cnlohr/x32-ws2812-usbhs-breakout/README.md

# 32x parallel WS 2812 Driver with High-Speed USB

This project leverages the CH32V305's USB High Speed USB interface as well as its timer-driven DMA to enable outputting to thousands of LEDs at >144 Hz!

(More documentation coming soon)
