cnlohr/x32-ws2812-usbhs-breakout/hardware-atx-psu-12v-led/mainboard.kicad_pcb

## KiCad design hardware-atx-psu-12v-led/mainboard.kicad_pcb (2025-12-19)

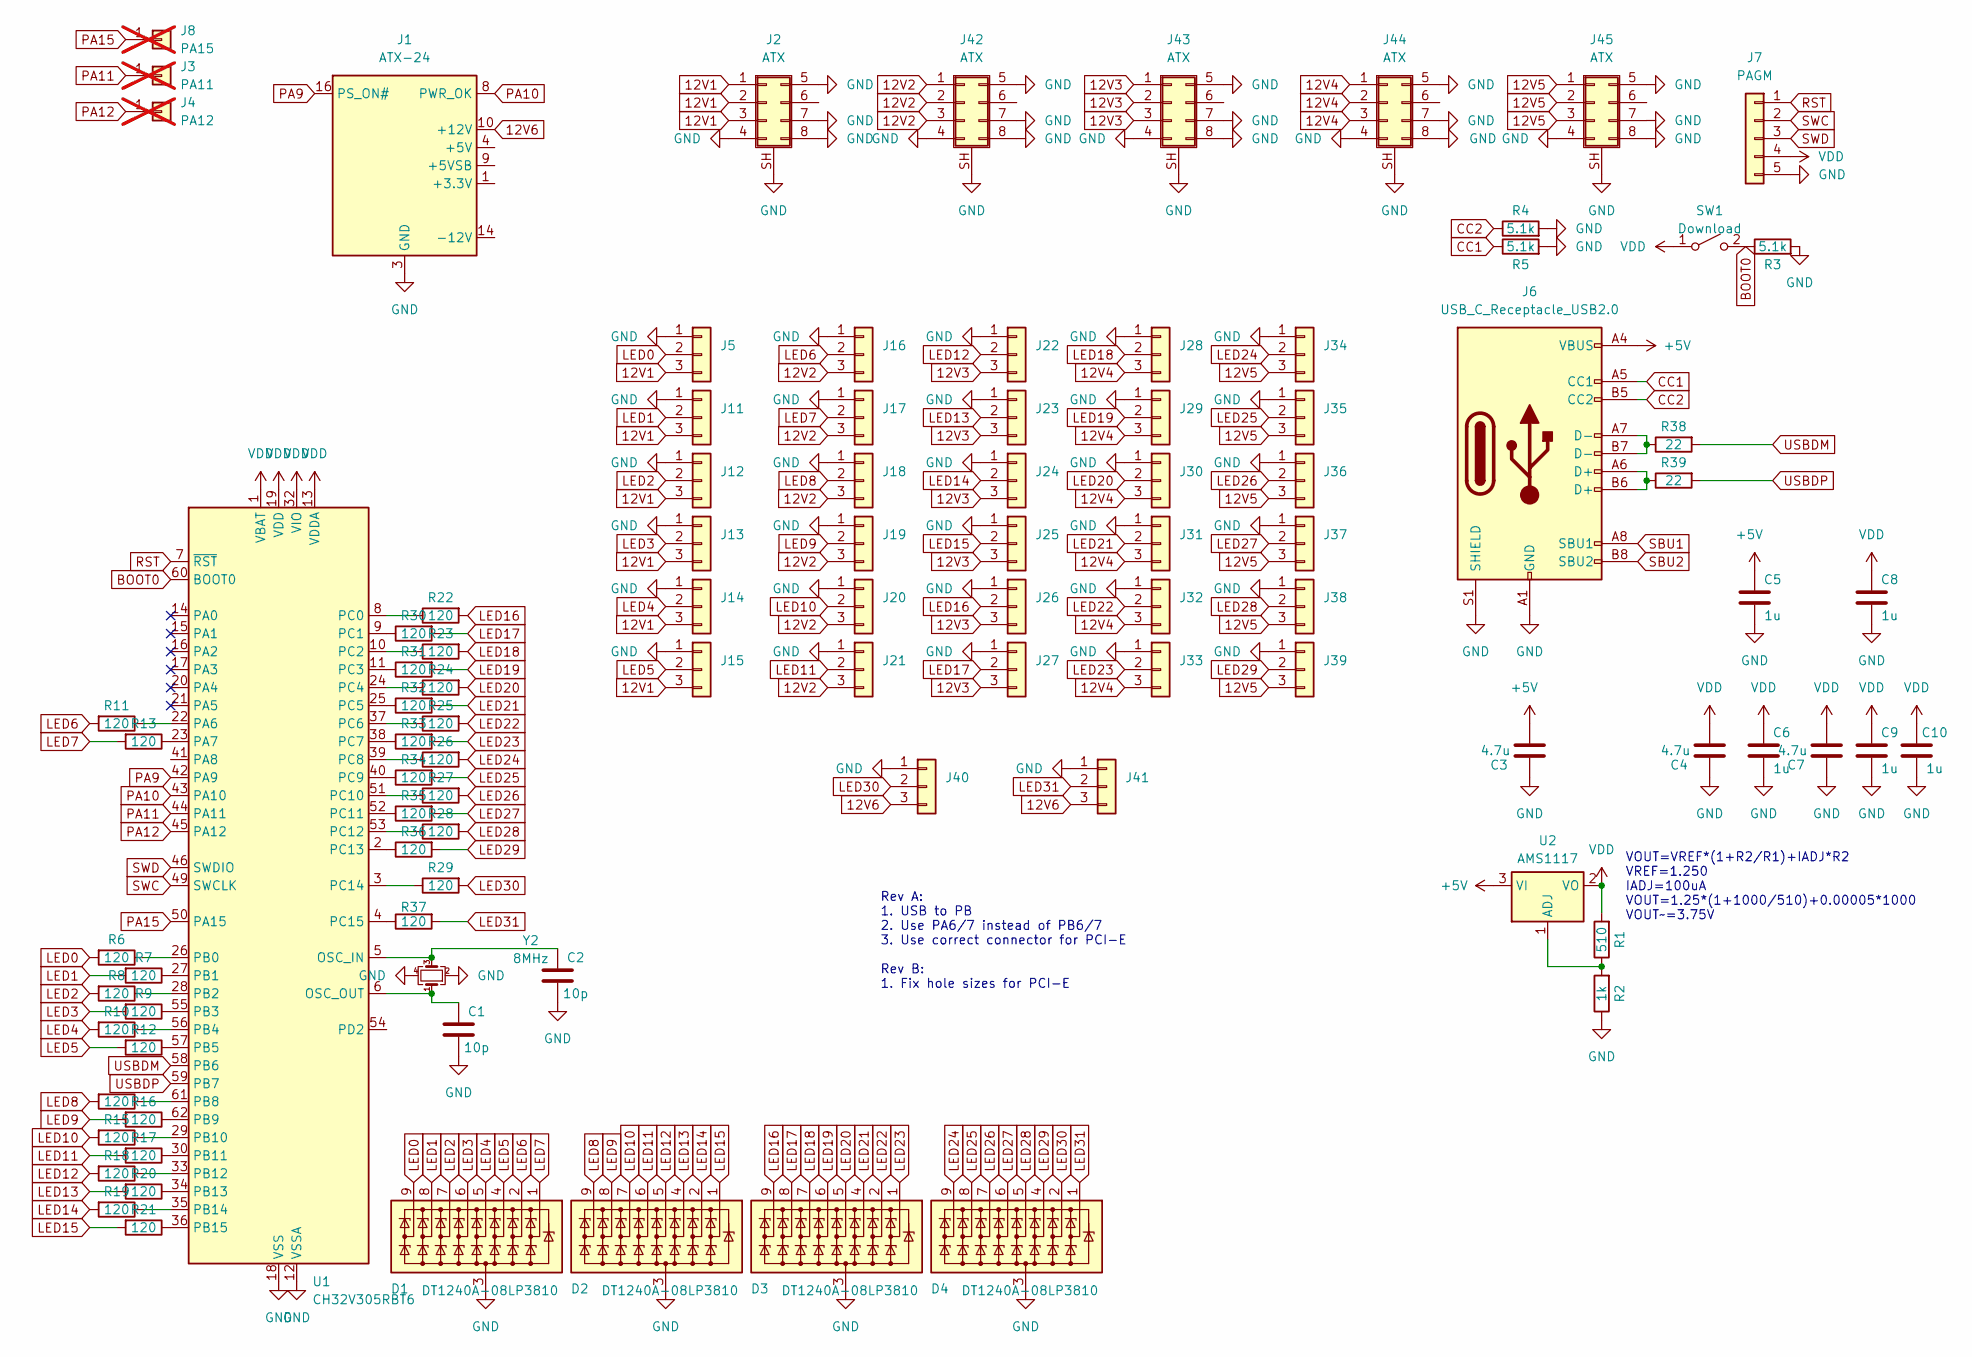
[picture p1: schematic mainboard.kicad_sch]

Parts:
C1, C2: 10p; R_0402_1005Metric; LCSC C32949
C3, C4, C7: 4.7u; C_0805_2012Metric; LCSC C1779
C5, C6, C8, C9, C10: 1u; R_0402_1005Metric; LCSC C52923
D1, D2, D3, D4: DT1240A-08LP3810; UDFN-9_1.0x3.8mm_P0.5mm; LCSC C526598
J1: ATX-24; Molex_Mini-Fit_Jr_5566-24A2_2x12_P4.20mm_Vertical; LCSC C114125
J2, J42, J43, J44, J45: ATX; Molex_Mini-Fit_-PCI_EXPRESS-_2x04_P4.20mm_Vertical; LCSC C2886679
J3: PA11; TestPoint_Pad_D1.0mm; not fitted
J4: PA12; TestPoint_Pad_D1.0mm; not fitted
J5, J11, J12, J13, J14, J15, J16, J17, J18, J19, J20, J21, J22, J23, J24, J25, J26, J27, J28, J29, J30, J31, J32, J33, J34, J35, J36, J37, J38, J39, J40, J41: LED; TerminalBlock_TE_282834-3_1x03_P2.54mm_Horizontal; LCSC C234181
J6: USB_C_Receptacle_USB2.0; USB_C_Receptacle_HRO_TYPE-C-31-M-12; LCSC C2765186
J7: PAGM; PinHeader_1x05_P2.54mm_Vertical; LCSC C32713271
J8: PA15; TestPoint_Pad_D1.0mm; not fitted
R1: 510; R_0402_1005Metric; LCSC C25123
R2: 1k; R_0402_1005Metric; LCSC C11702
R3, R4, R5: 5.1k; R_0402_1005Metric; LCSC C25905
R6, R7, R8, R9, R10, R11, R12, R13, R14, R15, R16, R17, R18, R19, R20, R21, R22, R23, R24, R25, R26, R27, R28, R29, R30, R31, R32, R33, R34, R35, R36, R37: 120; R_0402_1005Metric; LCSC C25079
R38, R39: 22; R_0402_1005Metric; LCSC C25092
SW1: Download; SW_SPST_TL3342; LCSC C318884
U1: CH32V305RBT6; LQFP-64_10x10mm_P0.5mm; LCSC C5187529
U2: AMS1117; SOT-223-3_TabPin2; LCSC C110475
Y2: 8MHz; Crystal_SMD_3225-4Pin_3.2x2.5mm_HandSoldering; LCSC C367183

Connections:
12V1: J2.1, J2.2, J2.3, J5.3, J11.3, J12.3, J13.3, J14.3, J15.3
12V2: J16.3, J17.3, J18.3, J19.3, J20.3, J21.3, J42.1, J42.2, J42.3
12V3: J22.3, J23.3, J24.3, J25.3, J26.3, J27.3, J43.1, J43.2, J43.3
12V4: J28.3, J29.3, J30.3, J31.3, J32.3, J33.3, J44.1, J44.2, J44.3
12V5: J34.3, J35.3, J36.3, J37.3, J38.3, J39.3, J45.1, J45.2, J45.3
12V6: J1.10 (+12V), J1.11 (+12V), J40.3, J41.3
+5V: C3.2, C5.2, J6.A4 (VBUS), J6.A9 (VBUS), J6.B4 (VBUS), J6.B9 (VBUS), U2.3 (VI)
BOOT0: R3.1, SW1.2 (B), U1.60 (BOOT0)
CC1: J6.A5 (CC1), R5.1
CC2: J6.B5 (CC2), R4.1
GND: C1.1, C2.1, C3.1, C4.1, C5.1, C6.1, C7.1, C8.1, C9.1, C10.1, D1.3 (A), D2.3 (A), D3.3 (A), D4.3 (A), J1.3 (GND), J1.5 (GND), J1.7 (GND), J1.15 (GND), J1.17 (GND), J1.18 (GND), J1.19 (GND), J1.24 (GND), J2.4, J2.5, J2.7, J2.8, J2.SH (Shield), J5.1, J6.A1 (GND), J6.A12 (GND), J6.B1 (GND), J6.B12 (GND), J6.S1 (SHIELD), J7.5, J11.1, J12.1, J13.1, J14.1, J15.1, J16.1, J17.1, J18.1, J19.1, J20.1, J21.1, J22.1, J23.1, J24.1, J25.1, J26.1, J27.1, J28.1, J29.1, J30.1, J31.1, J32.1, J33.1, J34.1, J35.1, J36.1, J37.1, J38.1, J39.1, J40.1, J41.1, J42.4, J42.5, J42.7, J42.8, J42.SH (Shield), J43.4, J43.5, J43.7, J43.8, J43.SH (Shield), J44.4, J44.5, J44.7, J44.8, J44.SH (Shield), J45.4, J45.5, J45.8, J45.SH (Shield), R2.1, R3.2, R4.2, R5.2, U1.12 (VSSA), U1.18 (VSS), U1.31 (VSS), U1.47 (VSS), U1.63 (VSS), Y2.2, Y2.4
LED0: D1.9 (K8), J5.2, R6.2
LED1: D1.8 (K7), J11.2, R7.2
LED2: D1.7 (K6), J12.2, R8.2
LED3: D1.6 (K5), J13.2, R9.2
LED4: D1.5 (K4), J14.2, R10.2
LED5: D1.4 (K3), J15.2, R12.2
LED6: D1.2 (K2), J16.2, R11.2
LED7: D1.1 (K1), J17.2, R13.2
LED8: D2.9 (K8), J18.2, R14.2
LED9: D2.8 (K7), J19.2, R16.2
LED10: D2.7 (K6), J20.2, R15.2
LED11: D2.6 (K5), J21.2, R17.2
LED12: D2.5 (K4), J22.2, R18.2
LED13: D2.4 (K3), J23.2, R20.2
LED14: D2.2 (K2), J24.2, R19.2
LED15: D2.1 (K1), J25.2, R21.2
LED16: D3.9 (K8), J26.2, R22.2
LED17: D3.8 (K7), J27.2, R30.2
LED18: D3.7 (K6), J28.2, R23.2
LED19: D3.6 (K5), J29.2, R31.2
LED20: D3.5 (K4), J30.2, R24.2
LED21: D3.4 (K3), J31.2, R32.2
LED22: D3.2 (K2), J32.2, R25.2
LED23: D3.1 (K1), J33.2, R33.2
LED24: D4.9 (K8), J34.2, R26.2
LED25: D4.8 (K7), J35.2, R34.2
LED26: D4.7 (K6), J36.2, R27.2
LED27: D4.6 (K5), J37.2, R35.2
LED28: D4.5 (K4), J38.2, R28.2
LED29: D4.4 (K3), J39.2, R36.2
LED30: D4.2 (K2), J40.2, R29.2
LED31: D4.1 (K1), J41.2, R37.2
unnamed: J1.1 (+3.3V), J1.2 (+3.3V), J1.12 (+3.3V), J1.13 (+3.3V)
unnamed: J1.4 (+5V), J1.6 (+5V), J1.21 (+5V), J1.22 (+5V), J1.23 (+5V)
unnamed: J6.A6 (D+), J6.B6 (D+), R39.1
unnamed: J6.A7 (D-), J6.B7 (D-), R38.1
unnamed: C2.2, U1.5 (OSC_IN), Y2.3
unnamed: C1.2, U1.6 (OSC_OUT), Y2.1
unnamed: R11.1, U1.22 (PA6)
unnamed: R13.1, U1.23 (PA7)
unnamed: R6.1, U1.26 (PB0)
unnamed: R7.1, U1.27 (PB1)
unnamed: R8.1, U1.28 (PB2)
unnamed: R9.1, U1.55 (PB3)
unnamed: R10.1, U1.56 (PB4)
unnamed: R12.1, U1.57 (PB5)
unnamed: R14.1, U1.61 (PB8)
unnamed: R16.1, U1.62 (PB9)
unnamed: R15.1, U1.29 (PB10)
unnamed: R17.1, U1.30 (PB11)
unnamed: R18.1, U1.33 (PB12)
unnamed: R20.1, U1.34 (PB13)
unnamed: R19.1, U1.35 (PB14)
unnamed: R21.1, U1.36 (PB15)
unnamed: R22.1, U1.8 (PC0)
unnamed: R30.1, U1.9 (PC1)
unnamed: R23.1, U1.10 (PC2)
unnamed: R31.1, U1.11 (PC3)
unnamed: R24.1, U1.24 (PC4)
unnamed: R32.1, U1.25 (PC5)
unnamed: R25.1, U1.37 (PC6)
unnamed: R33.1, U1.38 (PC7)
unnamed: R26.1, U1.39 (PC8)
unnamed: R34.1, U1.40 (PC9)
unnamed: R27.1, U1.51 (PC10)
unnamed: R35.1, U1.52 (PC11)
unnamed: R28.1, U1.53 (PC12)
unnamed: R36.1, U1.2 (PC13)
unnamed: R29.1, U1.3 (PC14)
unnamed: R37.1, U1.4 (PC15)
unnamed: R1.1, R2.2, U2.1 (ADJ)
PA9: J1.16 (PS_ON#), U1.42 (PA9)
PA10: J1.8 (PWR_OK), U1.43 (PA10)
PA11: J3.1, U1.44 (PA11)
PA12: J4.1, U1.45 (PA12)
PA15: J8.1, U1.50 (PA15)
RST: J7.1, U1.7 (~RST)
SBU1: J6.A8 (SBU1)
SBU2: J6.B8 (SBU2)
SWC: J7.2, U1.49 (SWCLK)
SWD: J7.3, U1.46 (SWDIO)
USBDM: R38.2, U1.58 (PB6)
USBDP: R39.2, U1.59 (PB7)
VDD: C4.2, C6.2, C7.2, C8.2, C9.2, C10.2, J7.4, R1.2, SW1.1 (A), U1.1 (VBAT), U1.13 (VDDA), U1.19 (VDD), U1.32 (VIO), U1.48 (VDD), U1.64 (VIO), U2.2 (VO)

Notes on the sheet:
Rev A: 1. USB to PB 2. Use PA6/7 instead of PB6/7 3. Use correct connector for PCI-E Rev B: 1. Fix hole sizes for PCI-E
VOUT=VREF*(1+R2/R1)+IADJ*R2 VREF=1.250 IADJ=100uA VOUT=1.25*(1+1000/510)+0.00005*1000 VOUT~=3.75V

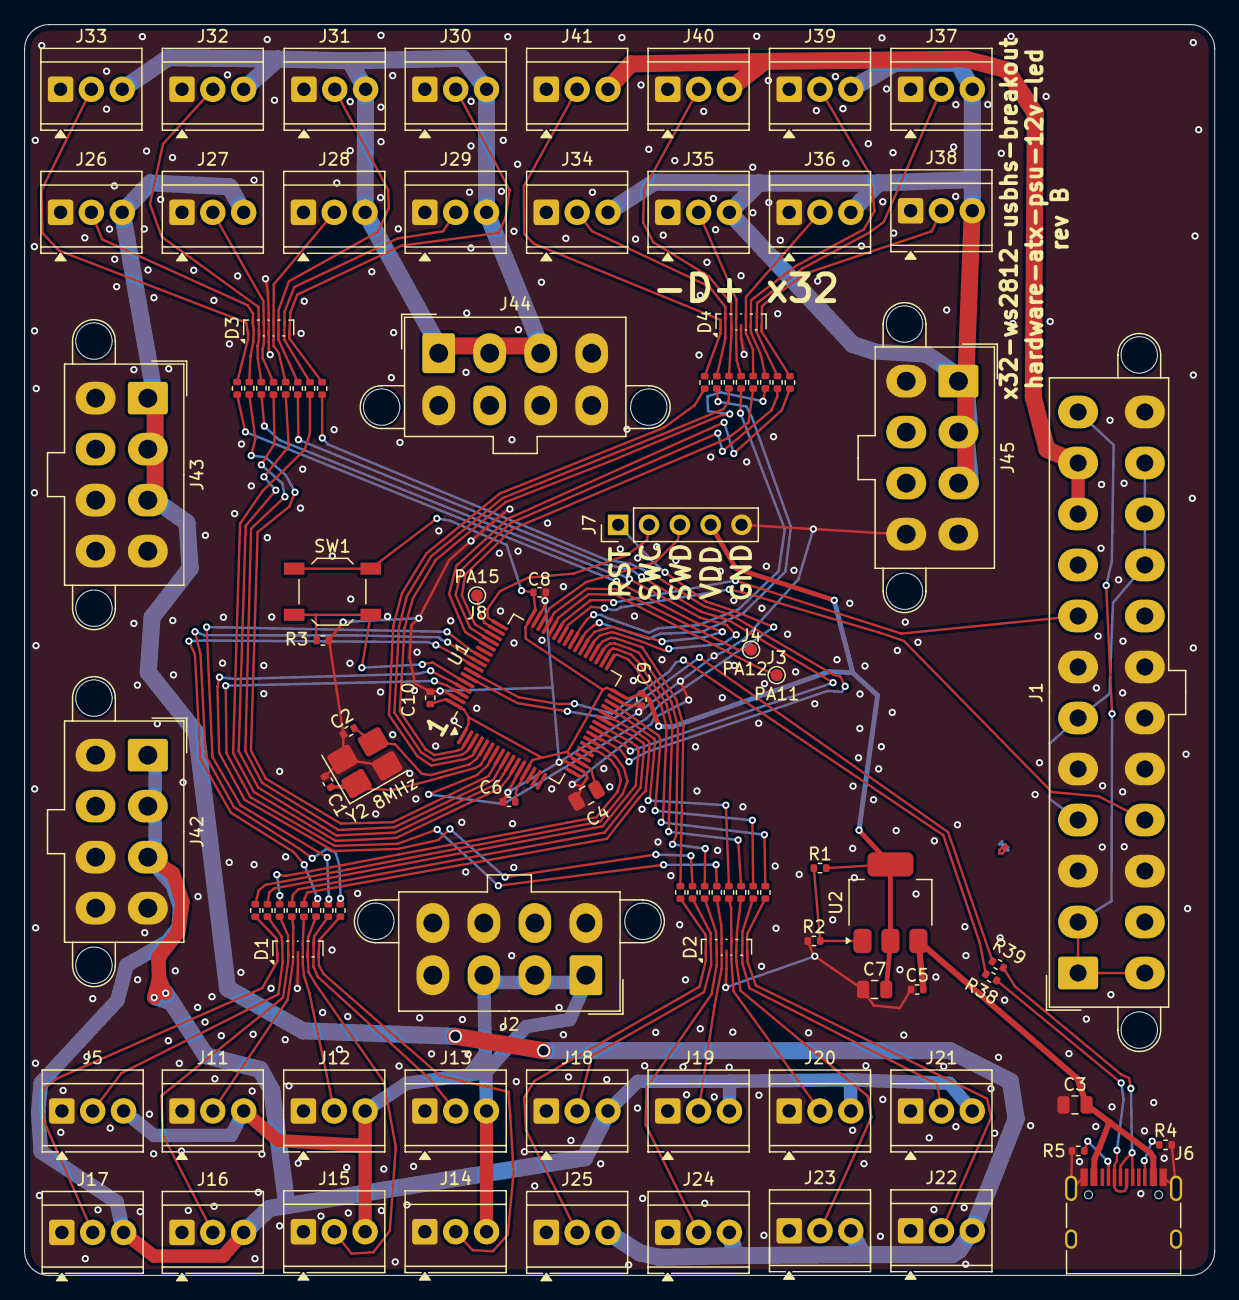
[picture p2: board mainboard.kicad_pcb from above]

Board: 2 copper layers, 98.0 x 103.0 mm, 100 parts (0 on the bottom side), 93 nets.
