cnlohr/x32-ws2812-usbhs-breakout/firmware/firmware.c

#include "ch32fun.h"
#include <stdio.h>
#include <string.h>
#include "hsusb_v30x.h"
#include "hsusb_v30x.c" // Normally would be in ADDITIONAL_C_FILES, but the PIO build system doesn't currently understand that.


struct usb_string_descriptor_struct_serial_16 string3;

uint32_t count;
int dummy = 1; // Dummy data being sent (no host)
int streaming = 0;
int need_to_confirm = 0;

#define BUFFER_SIZE_WORDS 7368 // 306 LEDs max.
volatile uint32_t memory_buffer[BUFFER_SIZE_WORDS] __attribute__((aligned(4)));
static const uint16_t set_zero[1] __attribute__((aligned(4))) =  { 0x0000 };
static const uint16_t set_one[1]  __attribute__((aligned(4))) =  { 0xffff };



#define HALF_BUFFER_BYTES (BUFFER_SIZE_WORDS*4/2)

#define TRIG_FULLCYCLE 35*4+3                         // Minimum = 32 --> Selecting 33 or 34 -- sooooometimes 33 doesn't quiiiiite work, so let's go to 34.
#define TRIG_INITIAL 0 
#define TRIG_DATA 12*4                        // Minimum = 9
#define TRIG_ZERO 26*4                        //  Minimum = 22


int last = 0;
int lrx = 0;
uint8_t scratchpad[2048] __attribute__((aligned(32)));

void TriggerEnable( int nrsamps )
{
	TIM1->CTLR1 = 0;
	TIM2->CTLR1 = 0;
	TIM10->CTLR1 = 0;

	
	// Make sure lines are zeroed.
	GPIOC->OUTDR = 0x0;
	GPIOB->OUTDR = 0x0;
	GPIOA->OUTDR &= 0xff00;

	// TIM1CH2
	DMA1_Channel3->CNTR = nrsamps;
	DMA1_Channel3->MADDR = (uint32_t)(memory_buffer);
	DMA1_Channel3->PADDR = (uint32_t)&GPIOC->OUTDR;
	DMA1_Channel3->CFGR = 
		DMA_CFGR1_DIR |                      // MEM2PERIPHERAL
		DMA_CFGR1_PL |                       // High priority.
		DMA_CFGR1_MSIZE_0 |                  // 16-bit memory
		DMA_CFGR1_PSIZE_0 |                  // 16-bit peripheral
		DMA_CFGR1_MINC |                     // Increase memory.
		0 |                     // Circular mode.
		//DMA_CFGR1_HTIE |                     // Half-trigger
		//DMA_CFGR1_TCIE |                     // Whole-trigger
		DMA_CFGR1_EN;                        // Enable


	// TIM2CH2
	DMA1_Channel7->CNTR = nrsamps;
	DMA1_Channel7->MADDR = ((uint32_t)memory_buffer)+HALF_BUFFER_BYTES;
	DMA1_Channel7->PADDR = (uint32_t)&GPIOB->OUTDR;
	DMA1_Channel7->CFGR = 
		DMA_CFGR1_DIR |                      // MEM2PERIPHERAL
		DMA_CFGR1_PL |                       // High priority.
		DMA_CFGR1_MSIZE_0 |                  // 16-bit memory
		DMA_CFGR1_PSIZE_0 |                  // 16-bit peripheral
		DMA_CFGR1_MINC |                     // Increase memory.
		0 |                     // Circular mode.
		//DMA_CFGR1_HTIE |                     // Half-trigger
		//DMA_CFGR1_TCIE |                     // Whole-trigger
		DMA_CFGR1_EN;                        // Enable


	// TIM10CH2
	DMA2_Channel10->CNTR = nrsamps;
	DMA2_Channel10->MADDR = ((uint32_t)memory_buffer)+HALF_BUFFER_BYTES;
	DMA2_Channel10->PADDR = (uint32_t)&GPIOA->OUTDR;
	DMA2_Channel10->CFGR = 
		DMA_CFGR1_DIR |                      // MEM2PERIPHERAL
		DMA_CFGR1_PL |                       // High priority.
		DMA_CFGR1_MSIZE_0 |                  // 16-bit memory
		0              |                     // 8-bit peripheral
		DMA_CFGR1_MINC |                     // Increase memory.
		0 |                     // Circular mode.
		//DMA_CFGR1_HTIE |                     // Half-trigger
		//DMA_CFGR1_TCIE |                     // Whole-trigger
		DMA_CFGR1_EN;                        // Enable



	// The LED lines need a little longer for the first bit.
	TIM1->CNT = 0;
	GPIOC->OUTDR = 0xffff;
	// Stagger timer controls.
	TIM1->CTLR1 = TIM_CEN;

	TIM2->CNT = 0;
	GPIOB->OUTDR = 0xffff;
	TIM2->CTLR1 = TIM_CEN;

	TIM10->CNT = 0;
	GPIOA->OUTDR |= 0xff;
	TIM10->CTLR1 = TIM_CEN;

	streaming = 1;

}

void handle_debug_input( int numbytes, uint8_t * data )
{
	last = data[0];
	count += numbytes;
}

int HandleHidUserSetReportSetup( struct _USBState * ctx, tusb_control_request_t * req )
{
	int id = req->wValue & 0xff;
	if( id == 0xaa && req->wLength <= sizeof(scratchpad) )
	{
		ctx->pCtrlPayloadPtr = scratchpad;
		lrx = req->wLength;
		return req->wLength;
	}
	return 0;
}

int HandleHidUserGetReportSetup( struct _USBState * ctx, tusb_control_request_t * req )
{
	int id = req->wValue & 0xff;
	if( id == 0xaa )
	{
		ctx->pCtrlPayloadPtr = scratchpad;
		if( sizeof(scratchpad) - 1 < lrx )
			return sizeof(scratchpad) - 1;
		else
			return lrx;
	}
	return 0;
}

void HandleHidUserReportDataOut( struct _USBState * ctx, uint8_t * data, int len )
{
}

int HandleHidUserReportDataIn( struct _USBState * ctx, uint8_t * data, int len )
{
	return len;
}

void HandleHidUserReportOutComplete( struct _USBState * ctx )
{
	return;
}


void HandleGotEPComplete( struct _USBState * ctx, int ep )
{
	if( ep == 5 )
	{
		dummy = 0;

		if( streaming )
		{
			need_to_confirm = 1;
			return;
		}

		need_to_confirm = 0;

		// Received data is written into scratchpad,
		// and USBHSD->RX_LEN

		uint16_t * sp = (uint16_t*)scratchpad;
		int term = sp[0] >> 15;
		int offset = sp[0] & 0x7fff; // in words
		int remain = sp[1]; // In words

		if( offset == 0x7fff )
		{
			// Control word
			HSUSBCTX.USBHS_Endp_Busy[5] = 0;

			TIM1->ATRLR = sp[2];
			TIM1->CH1CVR = sp[3];
			TIM1->CH2CVR = sp[4];
			TIM1->CH3CVR = sp[5];

			TIM2->ATRLR = sp[2];
			TIM2->CH1CVR = sp[3];
			TIM2->CH2CVR = sp[4];
			TIM2->CH3CVR = sp[5];

			TIM10->ATRLR = sp[2];
			TIM10->CH1CVR = sp[3];
			TIM10->CH2CVR = sp[4];
			TIM10->CH3CVR = sp[5];
		}
		else
		{
			int ofs_start = offset;
			int ofs_end = offset + remain + 1;

			if( ofs_start > sizeof(memory_buffer)/sizeof(memory_buffer[0]) )
			{
				ofs_start = sizeof(memory_buffer)/sizeof(memory_buffer[0]);
			}

			if( ofs_end > sizeof(memory_buffer)/sizeof(memory_buffer[0]) )
			{
				ofs_end = sizeof(memory_buffer)/sizeof(memory_buffer[0]);
			}

			// If invalid just truncate.
			if( ofs_end - ofs_start > 126 )
				ofs_end = ofs_start + 126;

			uint32_t * spp = (uint32_t*)(scratchpad + 4); // Remove header.

			// Don't use do...while here because start could == end.
			uint16_t * mba = ofs_start + (uint16_t*)&memory_buffer;
			uint16_t * mbb = mba + HALF_BUFFER_BYTES/2;  ////////////////////////////XXX XXX XXX WHY??!? +1 SOMETIMES fixes things.
			uint32_t * sppend = spp + (ofs_end - ofs_start);
			while( spp != sppend )
			{
				uint32_t v = *(spp++);
				*(mba++) = v & 0xffff;
				*(mbb++) = v >> 16;
			}

			if( term )
			{
				TriggerEnable( (offset + remain + 1) );
			}
			else
			{
				HSUSBCTX.USBHS_Endp_Busy[5] = 0;
			}
		}

		// You must re-up these, not sure why but they get corrupt.
		USBHSD->UEP5_RX_DMA = (uintptr_t)scratchpad;
		USBHSD->UEP5_MAX_LEN = 1024;
		USBHSD->UEP5_RX_CTRL ^= USBHS_UEP_R_TOG_DATA1;
		USBHSD->UEP5_RX_CTRL = ((USBHSD->UEP5_RX_CTRL) & ~USBHS_UEP_R_RES_MASK) | USBHS_UEP_R_RES_ACK;
	}
}


int main()
{
	SystemInit();

	funGpioInitAll();

	funPinMode( PA3, GPIO_CFGLR_OUT_10Mhz_PP ); // Old PSU on signal
	funPinMode( PA9, GPIO_CFGLR_OUT_10Mhz_PP ); // New PSU on signal

    Delay_Ms(200);

	unsigned short * serial16 = string3.wString;
	int i;
	for( i = 0; i < 17; i++ )
	{
		int v = (&ESIG->UID0)[i>>3];
		v>>=(4*(7-(i&7)));
		v &= 0xf;
		if( v >= 10 )
			serial16[i] = 'a' + v - 10;
		else
			serial16[i] = '0' + v;
	}

	// Enable DMA
	HSUSBSetup();

	RCC->AHBPCENR = RCC_AHBPeriph_SRAM | RCC_AHBPeriph_DMA1 | RCC_AHBPeriph_DMA2 | RCC_AHBPeriph_DMA2 | RCC_AHBPeriph_USBHS;
	RCC->APB2PCENR = RCC_APB2Periph_TIM1 | RCC_APB2Periph_TIM10 | RCC_APB2Periph_AFIO  | RCC_APB2Periph_GPIOA | RCC_APB2Periph_GPIOB | RCC_APB2Periph_GPIOC | RCC_APB2Periph_GPIOD | RCC_APB2Periph_GPIOE;
	RCC->APB1PCENR |= RCC_APB1Periph_TIM2;

	funPinMode( PA9, GPIO_CFGLR_OUT_50Mhz_PP );
	funDigitalWrite( PA9, 0);

	funPinMode( PA6, GPIO_CFGLR_OUT_10Mhz_PP );
	funPinMode( PA7, GPIO_CFGLR_OUT_10Mhz_PP );

	GPIOC->CFGLR = 0x11111111; // All output.  All 10MHz
	GPIOC->CFGHR = 0x11111111; // All output.  All 10MHz

	GPIOB->CFGHR = 0x11111111; // All output.  All 10MHz
	GPIOB->CFGLR = 0xbb111111; // All output.  All 10MHz  (Except for USB pins, PB6, PB7)

	// DMA2 = T1CH1
	DMA1_Channel2->CNTR = 1;
	DMA1_Channel2->MADDR = (uint32_t)set_one;
	DMA1_Channel2->PADDR = (uint32_t)&GPIOC->OUTDR;
	DMA1_Channel2->CFGR = 
		DMA_CFGR1_DIR |                    // MEM2PERIPHERAL
		DMA_CFGR1_PL |                     // High priority.
		DMA_CFGR1_MSIZE_0 |                // 16-bit memory
		DMA_CFGR1_PSIZE_0 |                // 16-bit peripheral
		DMA_CFGR1_CIRC |                   // Circular mode.
		DMA_CFGR1_EN;                      // Enable

    // DMA3 = T1C2 configured later

    // DMA6 = T1C3
	DMA1_Channel6->CNTR = 1;
	DMA1_Channel6->MADDR = (uint32_t)set_zero;
	DMA1_Channel6->PADDR = (uint32_t)&GPIOC->OUTDR;
	DMA1_Channel6->CFGR = 
		DMA_CFGR1_DIR |                    // MEM2PERIPHERAL
		DMA_CFGR1_PL |                     // High priority.
		DMA_CFGR1_MSIZE_0 |                // 16-bit memory
		DMA_CFGR1_PSIZE_0 |                // 16-bit peripheral
		DMA_CFGR1_CIRC |                   // Circular mode.
		DMA_CFGR1_EN;                      // Enable

    // DMA5 = T2C1
	DMA1_Channel5->CNTR = 1;
	DMA1_Channel5->MADDR = (uint32_t)set_one;
	DMA1_Channel5->PADDR = (uint32_t)&GPIOB->OUTDR;
	DMA1_Channel5->CFGR = 
		DMA_CFGR1_DIR |                    // MEM2PERIPHERAL
		DMA_CFGR1_PL |                     // High priority.
		DMA_CFGR1_MSIZE_0 |                // 16-bit memory
		DMA_CFGR1_PSIZE_0 |                // 16-bit peripheral
		DMA_CFGR1_CIRC |                   // Circular mode.
		DMA_CFGR1_EN;                      // Enable


    // DMA7 = T2C2 configured later

	// DMA1 = T2C3
	DMA1_Channel1->CNTR = 1;
	DMA1_Channel1->MADDR = (uint32_t)set_zero;
	DMA1_Channel1->PADDR = (uint32_t)&GPIOB->OUTDR;
	DMA1_Channel1->CFGR = 
		DMA_CFGR1_DIR |                    // MEM2PERIPHERAL
		DMA_CFGR1_PL |                     // High priority.
		DMA_CFGR1_MSIZE_0 |                // 16-bit memory
		DMA_CFGR1_PSIZE_0 |                // 16-bit peripheral
		DMA_CFGR1_CIRC |                   // Circular mode.
		DMA_CFGR1_EN;                      // Enable


    // DMA8 = T10C1
	DMA2_Channel8->CNTR = 1;
	DMA2_Channel8->MADDR = (uint32_t)set_one;
	DMA2_Channel8->PADDR = (uint32_t)&GPIOA->OUTDR;
	DMA2_Channel8->CFGR = 
		DMA_CFGR1_DIR |                    // MEM2PERIPHERAL
		DMA_CFGR1_PL |                     // High priority.
		DMA_CFGR1_MSIZE_0 |                // 16-bit memory
		0                 |                // 8-bit peripheral
		DMA_CFGR1_CIRC |                   // Circular mode.
		DMA_CFGR1_EN;                      // Enable


    // DMA10 = T10C2 configured later

	// DMA9 = T10C3
	DMA2_Channel9->CNTR = 1;
	DMA2_Channel9->MADDR = (uint32_t)set_zero;
	DMA2_Channel9->PADDR = (uint32_t)&GPIOA->OUTDR;
	DMA2_Channel9->CFGR = 
		DMA_CFGR1_DIR |                    // MEM2PERIPHERAL
		DMA_CFGR1_PL |                     // High priority.
		0 |                                // 8-bit memory
		0 |                                // 8-bit peripheral
		DMA_CFGR1_CIRC |                   // Circular mode.
		DMA_CFGR1_EN;                      // Enable

	// Setup Timer1.
	RCC->APB2PRSTR = RCC_APB2Periph_TIM1 | RCC_APB2Periph_TIM10;    // Reset Timers
	RCC->APB1PRSTR = RCC_APB1Periph_TIM2;    // Reset Timers
	RCC->APB2PRSTR = 0;
	RCC->APB1PRSTR = 0;

	// Timer 1 setup.
	TIM1->PSC = 0x0000;                      // Prescaler 
	TIM1->ATRLR = TRIG_FULLCYCLE;
	TIM1->SWEVGR = TIM_UG | TIM_TG;          // Reload immediately + Trigger DMA
	TIM1->CH1CVR = TRIG_INITIAL;
	TIM1->CH2CVR = TRIG_DATA;
	TIM1->CH3CVR = TRIG_ZERO;
	TIM1->DMAINTENR = TIM_CC1DE | TIM_CC2DE | TIM_CC3DE;   // Trigger DMA on TC match 1 (DMA Ch2) and TC match 2 (DMA Ch3)
	TIM1->CTLR1 = TIM_CEN;                   // Enable TIM1

	// Timer 2 setup.
	TIM2->PSC = 0x0000;                      // Prescaler 
	TIM2->ATRLR = TRIG_FULLCYCLE;
	TIM2->SWEVGR = TIM_UG | TIM_TG;          // Reload immediately + Trigger DMA
	TIM2->CH1CVR = TRIG_INITIAL;
	TIM2->CH2CVR = TRIG_DATA;
	TIM2->CH3CVR = TRIG_ZERO;
	TIM2->DMAINTENR = TIM_CC1DE | TIM_CC2DE | TIM_CC3DE;   // Trigger DMA on TC match 1 (DMA Ch2) and TC match 2 (DMA Ch3)
	TIM2->CTLR1 = TIM_CEN;                   // Enable TIM1

	// Timer 10 setup.
	TIM10->PSC = 0x0000;                      // Prescaler 
	TIM10->ATRLR = TRIG_FULLCYCLE;
	TIM10->SWEVGR = TIM_UG | TIM_TG;          // Reload immediately + Trigger DMA
	TIM10->CH1CVR = TRIG_INITIAL;
	TIM10->CH2CVR = TRIG_DATA;
	TIM10->CH3CVR = TRIG_ZERO;
	TIM10->DMAINTENR = TIM_CC1DE | TIM_CC2DE | TIM_CC3DE;   // Trigger DMA on TC match 1 (DMA Ch2) and TC match 2 (DMA Ch3)
	TIM10->CTLR1 = TIM_CEN;                   // Enable TIM1


	// Override EP5
	USBHSD->UEP5_MAX_LEN = 1024; // Max allowed.
	USBHSD->UEP5_RX_DMA = (uintptr_t)scratchpad;


    int loopcount = 0;



	while(1)
	{
		__disable_irq();
		// Critical section.  Todo: Fixme Kinda jank.
		if( DMA1_Channel3->CNTR == 0 && streaming)
		{
			TIM1->CTLR1 = 0;
			GPIOC->OUTDR = 0;
			TIM1->CNT = 0;
			DMA1_Channel3->CFGR = 0;

			TIM2->CTLR1 = 0;
			GPIOB->OUTDR = 0;
			TIM2->CNT = 0;
			DMA1_Channel7->CFGR = 0;

			TIM10->CTLR1 = 0;
			GPIOA->OUTDR = 0;
			TIM10->CNT = 0;
			DMA2_Channel10->CFGR = 0;

			streaming = 0;
			if( need_to_confirm )
			{
				HandleGotEPComplete( &HSUSBCTX, 5 );
			}
		}
		__enable_irq();


		if( dummy )
		{
	        loopcount++;

			if( DMA1_Channel3->CNTR == 0 )
			{
				TIM1->CTLR1 = 0;
				GPIOC->OUTDR = 0;
				TIM1->CNT = 0;
				DMA1_Channel3->CFGR = 0;

				TIM2->CTLR1 = 0;
				GPIOB->OUTDR = 0;
				TIM2->CNT = 0;
				DMA1_Channel7->CFGR = 0;

				TIM10->CTLR1 = 0;
				GPIOA->OUTDR = 0;
				TIM10->CNT = 0;
				DMA2_Channel10->CFGR = 0;

				streaming = 0;

				//Delay_Us(280);
				static int frame;
				frame++;

				int i;

				uint16_t * mba = (uint16_t*)memory_buffer;
				uint16_t * mbb = mba + HALF_BUFFER_BYTES/2;

				for( i = 0; i < BUFFER_SIZE_WORDS; i++ )
				{
				   // memory_buffer[i] = (i&1)?0xffff:0x0000;
					int lno = i/24;
					int pos = i-(lno*24);

					int sel = ( (lno) + (frame>>5) ) & 3;

					uint16_t bcol = 0x0000;
					switch (sel)
					{
					case 0:
						if( pos < 8 )
							bcol = 0xffff;
						else if( pos < 16 )
							bcol = 0x0000;
						else
							bcol = 0xffff;
						break;
					case 1:
						if( pos < 8 )
							bcol = 0x0000;
						else if( pos < 16 )
							bcol = 0xffff;
						else
							bcol = 0xffff;
						break;
					case 2:
						if( pos < 8 )
							bcol = 0xffff;
						else if( pos < 16 )
							bcol = 0xffff;
						else
							bcol = 0x0000;
						break;
					default:
						if( pos < 8 )
							bcol = 0x0000;
						else if( pos < 16 )
							bcol = 0x0000;
						else
							bcol = 0x0000;
						break;
					}
					// dim down.
					if( ((pos & 7) < 2) ) bcol = 0;
					mba[i] = bcol;
					mbb[i] = bcol;
				}

				TriggerEnable(sizeof(memory_buffer) / sizeof(memory_buffer[0]));
			}
		}

	}
}
