cnlohr/x32-ws2812-usbhs-breakout/testtop2/color_utilities.h

/*
	Color utility functions for embedded systems

	Copyright 2023 <>< Charles Lohr, under the MIT-x11 or NewBSD License, you choose!
*/

#ifndef _COLOR_UTILITIES_H
#define _COLOR_UTILITIES_H

// To stop warnings about unused functions.
static uint32_t EHSVtoHEX( uint8_t hue, uint8_t sat, uint8_t val ) __attribute__((used));
static uint32_t TweenHexColors( uint32_t hexa, uint32_t hexb, int tween ) __attribute__((used));

static uint32_t EHSVtoHEX( uint8_t hue, uint8_t sat, uint8_t val )
{
	#define SIXTH1 43
	#define SIXTH2 85
	#define SIXTH3 128
	#define SIXTH4 171
	#define SIXTH5 213

	uint16_t or = 0, og = 0, ob = 0;

	hue -= SIXTH1; //Off by 60 degrees.

	//TODO: There are colors that overlap here, consider 
	//tweaking this to make the best use of the colorspace.

	if( hue < SIXTH1 ) //Ok: Yellow->Red.
	{
		or = 255;
		og = 255 - ((uint16_t)hue * 255) / (SIXTH1);
	}
	else if( hue < SIXTH2 ) //Ok: Red->Purple
	{
		or = 255;
		ob = (uint16_t)hue*255 / SIXTH1 - 255;
	}
	else if( hue < SIXTH3 )  //Ok: Purple->Blue
	{
		ob = 255;
		or = ((SIXTH3-hue) * 255) / (SIXTH1);
	}
	else if( hue < SIXTH4 ) //Ok: Blue->Cyan
	{
		ob = 255;
		og = (hue - SIXTH3)*255 / SIXTH1;
	}
	else if( hue < SIXTH5 ) //Ok: Cyan->Green.
	{
		og = 255;
		ob = ((SIXTH5-hue)*255) / SIXTH1;
	}
	else //Green->Yellow
	{
		og = 255;
		or = (hue - SIXTH5) * 255 / SIXTH1;
	}

	uint16_t rv = val;
	if( rv > 128 ) rv++;
	uint16_t rs = sat;
	if( rs > 128 ) rs++;

	//or, og, ob range from 0...255 now.
	//Need to apply saturation and value.

	or = (or * val)>>8;
	og = (og * val)>>8;
	ob = (ob * val)>>8;

	//OR..OB == 0..65025
	or = or * rs + 255 * (256-rs);
	og = og * rs + 255 * (256-rs);
	ob = ob * rs + 255 * (256-rs);
//printf( "__%d %d %d =-> %d\n", or, og, ob, rs );

	or >>= 8;
	og >>= 8;
	ob >>= 8;

	return or | (og<<8) | ((uint32_t)ob<<16);
}

static const unsigned char huetable[] = {
	0x00, 0x06, 0x0c, 0x12, 0x18, 0x1e, 0x24, 0x2a, 0x30, 0x36, 0x3c, 0x42, 0x48, 0x4e, 0x54, 0x5a, 
	0x60, 0x66, 0x6c, 0x72, 0x78, 0x7e, 0x84, 0x8a, 0x90, 0x96, 0x9c, 0xa2, 0xa8, 0xae, 0xb4, 0xba, 
	0xc0, 0xc6, 0xcc, 0xd2, 0xd8, 0xde, 0xe4, 0xea, 0xf0, 0xf6, 0xff, 0xff, 0xff, 0xff, 0xff, 0xff, 
	0xff, 0xff, 0xff, 0xff, 0xff, 0xff, 0xff, 0xff, 0xff, 0xff, 0xff, 0xff, 0xff, 0xff, 0xff, 0xff, 
	0xff, 0xff, 0xff, 0xff, 0xff, 0xff, 0xff, 0xff, 0xff, 0xff, 0xff, 0xff, 0xff, 0xff, 0xff, 0xff, 
	0xff, 0xff, 0xff, 0xff, 0xff, 0xff, 0xff, 0xff, 0xff, 0xff, 0xff, 0xff, 0xff, 0xff, 0xff, 0xff, 
	0xff, 0xff, 0xff, 0xff, 0xff, 0xff, 0xff, 0xff, 0xff, 0xff, 0xff, 0xff, 0xff, 0xff, 0xff, 0xff, 
	0xff, 0xff, 0xff, 0xff, 0xff, 0xff, 0xff, 0xff, 0xff, 0xff, 0xff, 0xff, 0xff, 0xff, 0xff, 0xff, 
	0xff, 0xf9, 0xf3, 0xed, 0xe7, 0xe1, 0xdb, 0xd5, 0xcf, 0xc9, 0xc3, 0xbd, 0xb7, 0xb1, 0xab, 0xa5, 
	0x9f, 0x99, 0x93, 0x8d, 0x87, 0x81, 0x7b, 0x75, 0x6f, 0x69, 0x63, 0x5d, 0x57, 0x51, 0x4b, 0x45, 
	0x3f, 0x39, 0x33, 0x2d, 0x27, 0x21, 0x1b, 0x15, 0x0f, 0x09, 0x00, 0x00, 0x00, 0x00, 0x00, 0x00, 
	0x00, 0x00, 0x00, 0x00, 0x00, 0x00, 0x00, 0x00, 0x00, 0x00, 0x00, 0x00, 0x00, 0x00, 0x00, 0x00, 
	0x00, 0x00, 0x00, 0x00, 0x00, 0x00, 0x00, 0x00, 0x00, 0x00, 0x00, 0x00, 0x00, 0x00, 0x00, 0x00, 
	0x00, 0x00, 0x00, 0x00, 0x00, 0x00, 0x00, 0x00, 0x00, 0x00, 0x00, 0x00, 0x00, 0x00, 0x00, 0x00, 
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
	int32_t b = (FastMultiply( hab, aamt ) + FastMultiply( hbb, bamt ) + 128) >> 8;
	int32_t r = (FastMultiply( har, aamt ) + FastMultiply( hbr, bamt ) + 128) >> 8;
	int32_t g = (FastMultiply( hag, aamt ) + FastMultiply( hbg, bamt ) + 128) >> 8;
	return b | (r<<8) | (g<<16);
}

#endif
