cnlohr/x32-ws2812-usbhs-breakout/(commit log)

2025-12-08 Add initial commit
    [mainboard.kicad_pcb, mainboard.kicad_sch]
2025-12-09 Fix for port b
    [firmware.c]
2025-12-09 Tweaked per these LEDs
2025-12-09 Add readme and move hardware
    [mainboard.kicad_pcb, mainboard.kicad_sch]
2025-12-10 Driverify tool
2025-12-10 Add note about device add
2025-12-10 Update with hpd but it doesn't quite work
    [x32breakoutdriver.h]
2025-12-19 Add revB
    [mainboard.kicad_pcb, mainboard.kicad_sch]
2025-12-19 Fix PB14, PB15 outputs
    [firmware.c]
